kkikione999/zmgjb/code/C3/readme.md

2025_1020_14:58

使用slot去解决：用一个消息队列传输不同类型的消息
问题：传输不同的消息之后还得做不同字符类型消息的解包工作，不好，故弃用
