kkikione999/zmgjb/code/record/attitude_static_charts.png

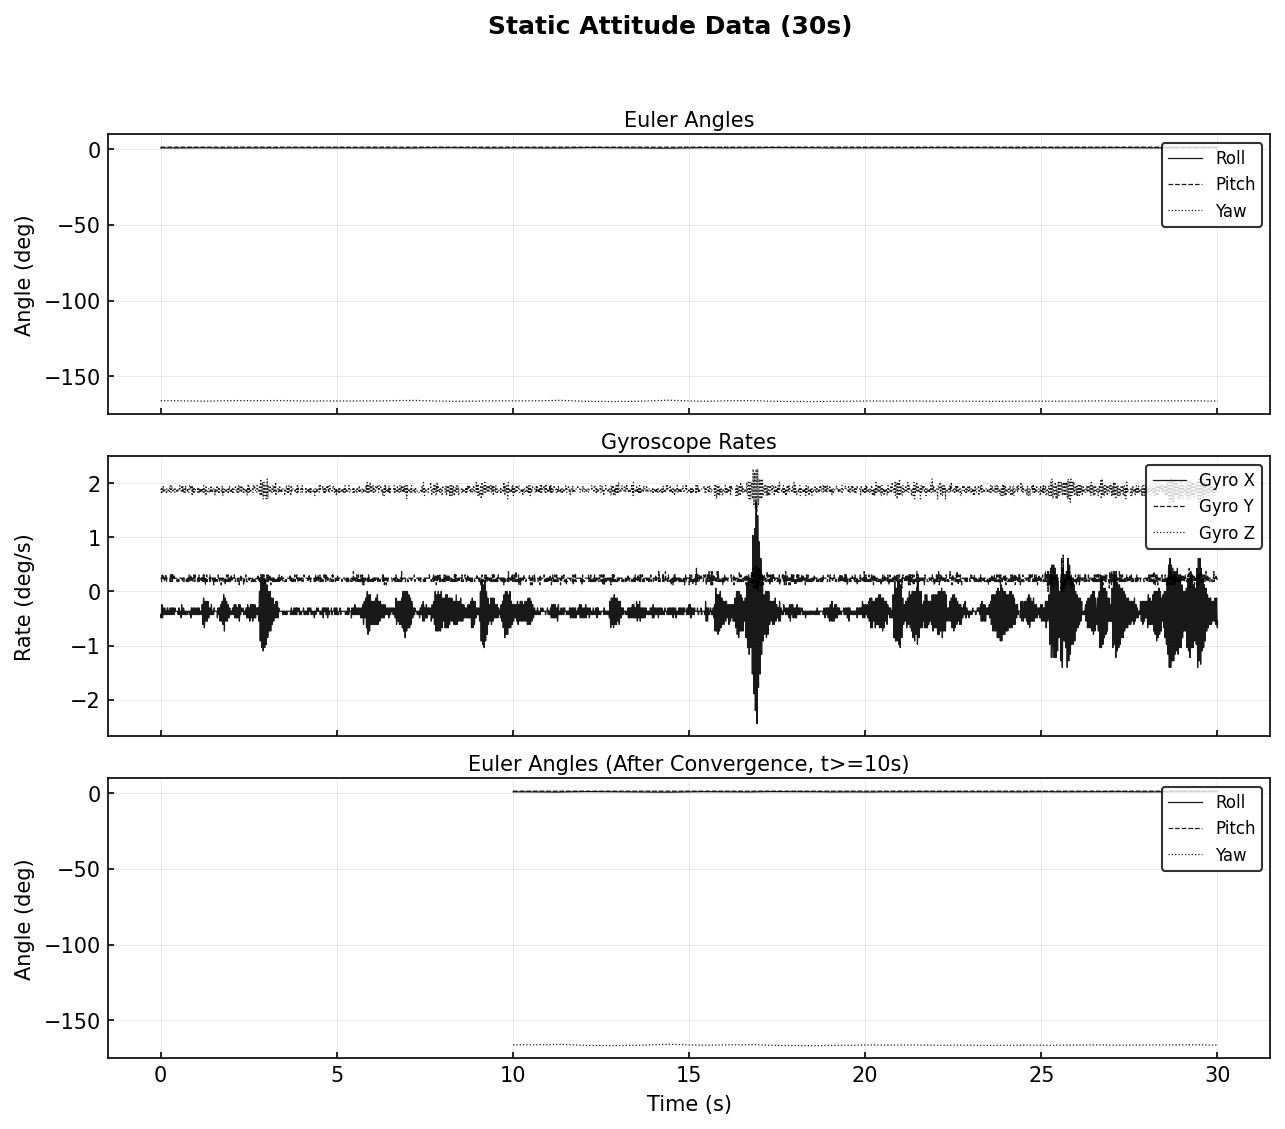
code/record/attitude_static_charts.png
