kkikione999/zmgjb/code/record/attitude_steady_detail.png

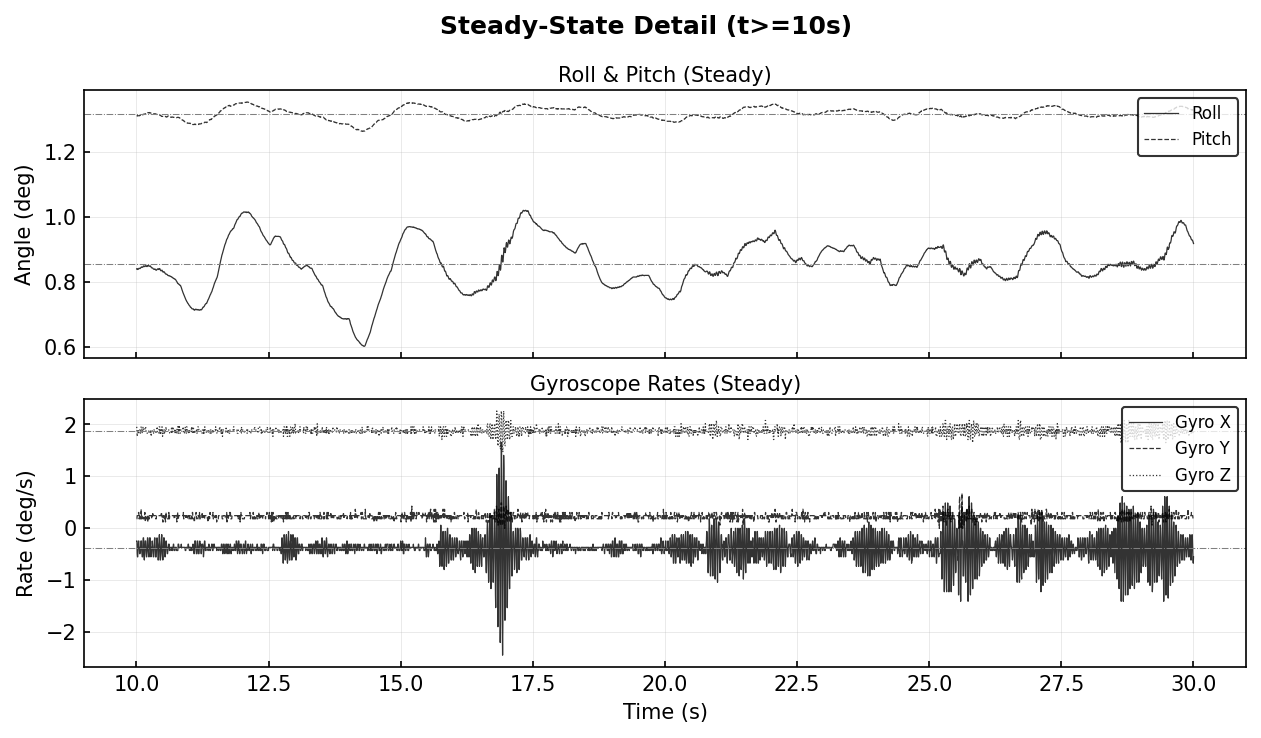
code/record/attitude_steady_detail.png
