kkikione999/zmgjb/code/record/rtt_comparison.png

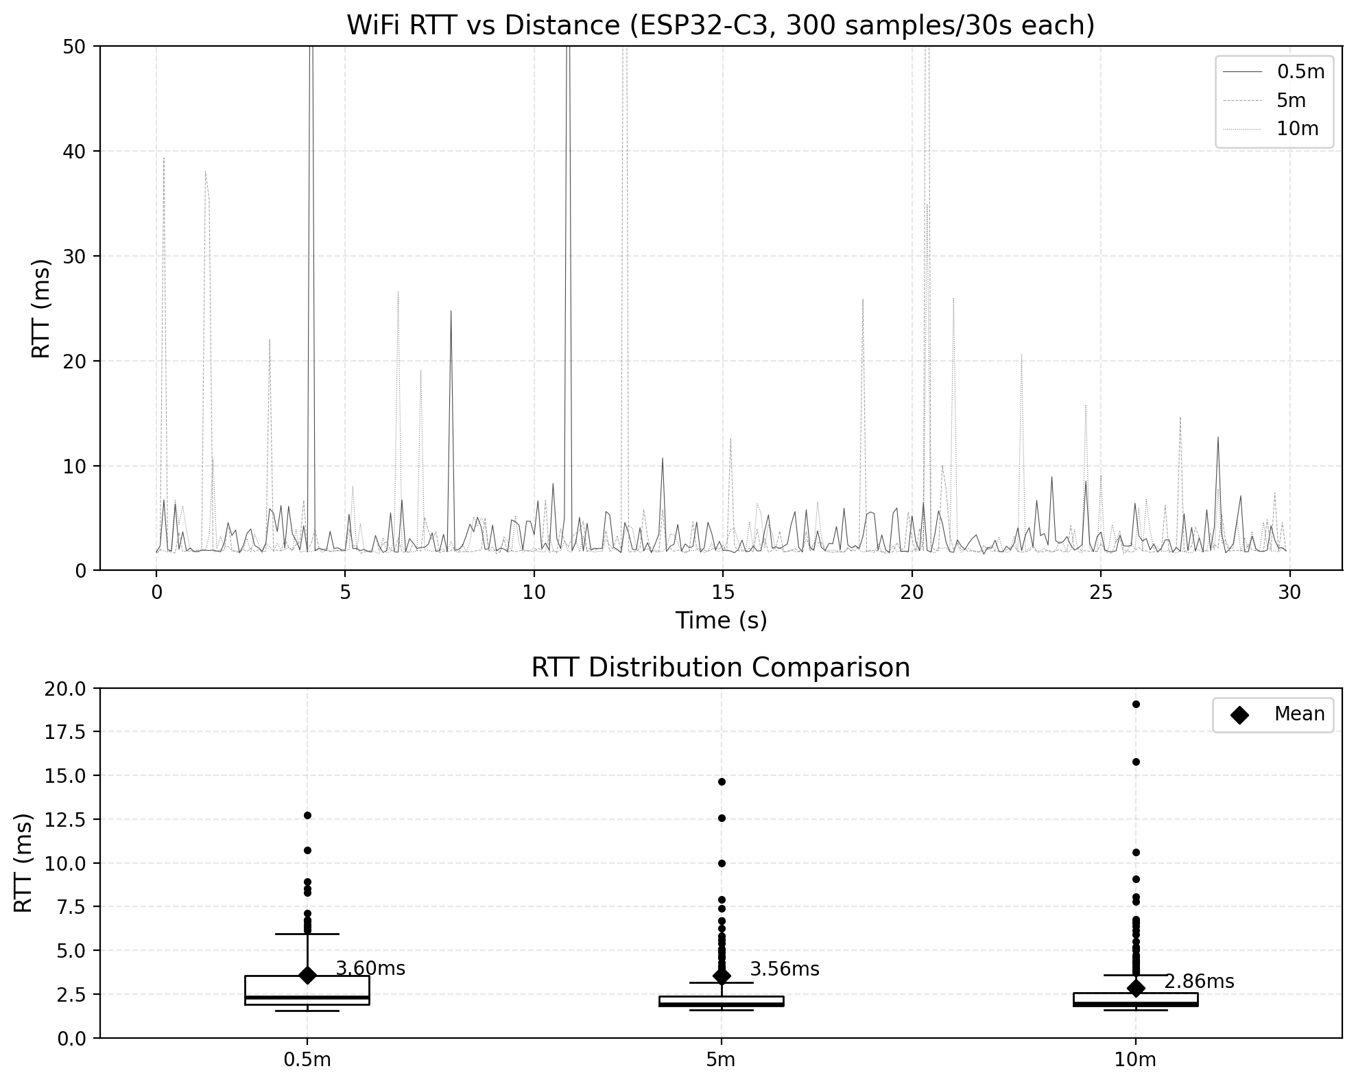
code/record/rtt_comparison.png
