kkikione999/zmgjb/hardware/原理图/主控/SCH_主控_1-P1_2026-03-11.pdf

IO19 27 IO18 26 NC 25 NC 24 IO9 23 IO8 22 IO7 21 IO6 20 IO5 19 IO4 18 NC 17 IO10 16 NC 15 GND 14 IO1 13 IO0 12 GND 11 NC 10 NC 9

# C1 10 GND 11 NC 12 NC 13 NC 14 NC 15 SDA 16

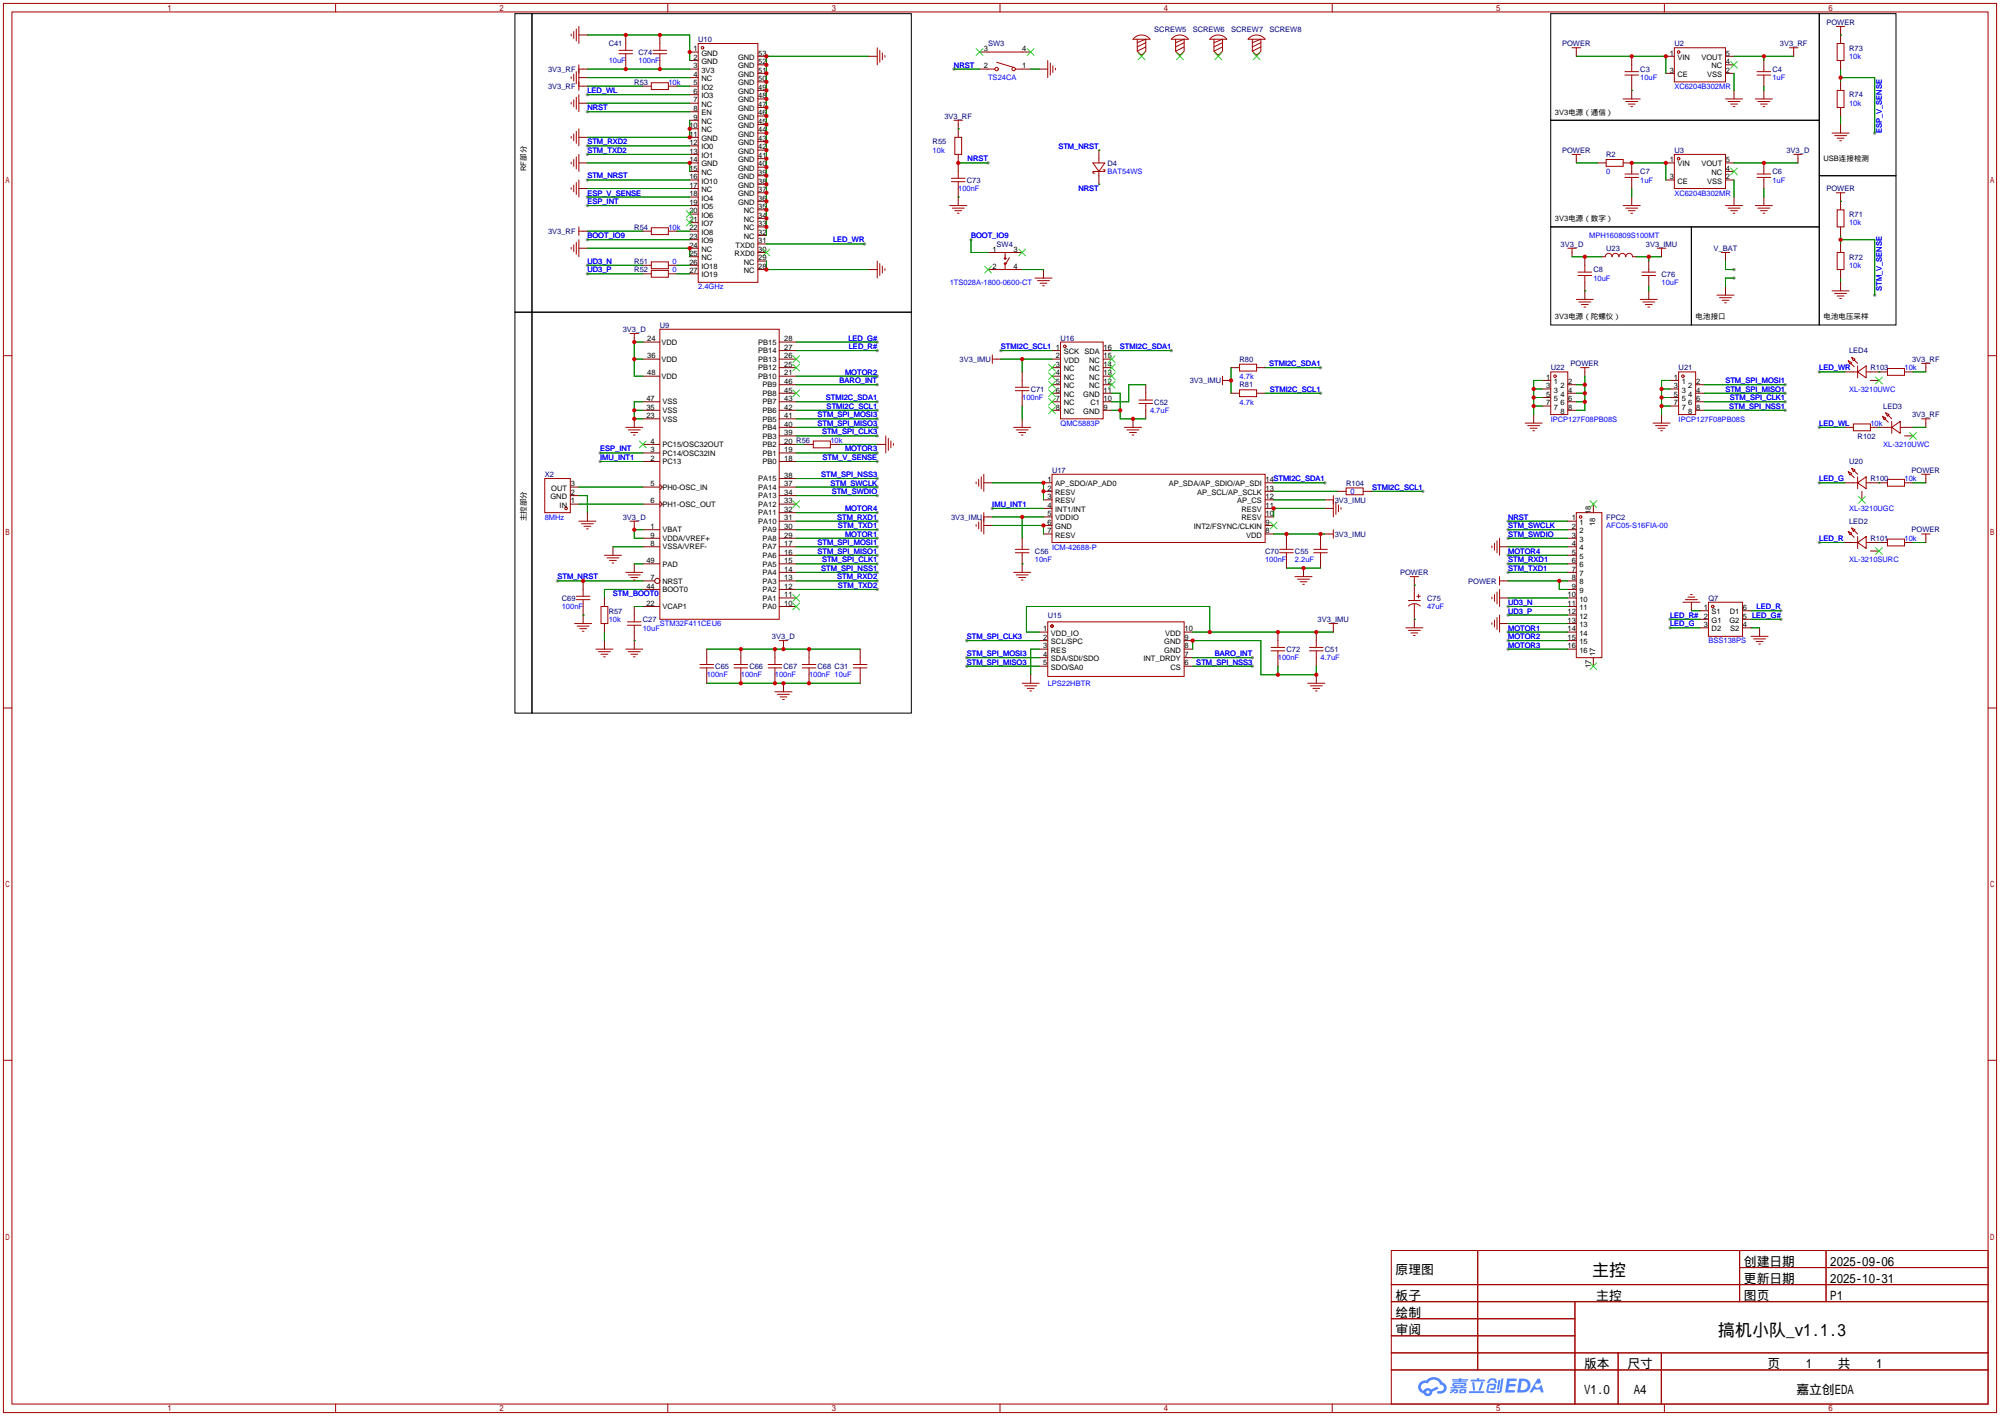
[picture p4: page 1]

原理图 | 主控 | 创建日期 | 2025-09-06

更新日期 | 2025-10-31

板子 | 主控 | 图页 | P1
绘制 | | 搞机小队_v1.1.3
审阅

V1.0 | A4 | 嘉立创EDA
