kkikione999/zmgjb/hardware/原理图/机身/SCH_机身_1-P1_2026-03-11.pdf

# FPC1 AFC⁰⁵⁻S¹⁶FIA⁻⁰⁰

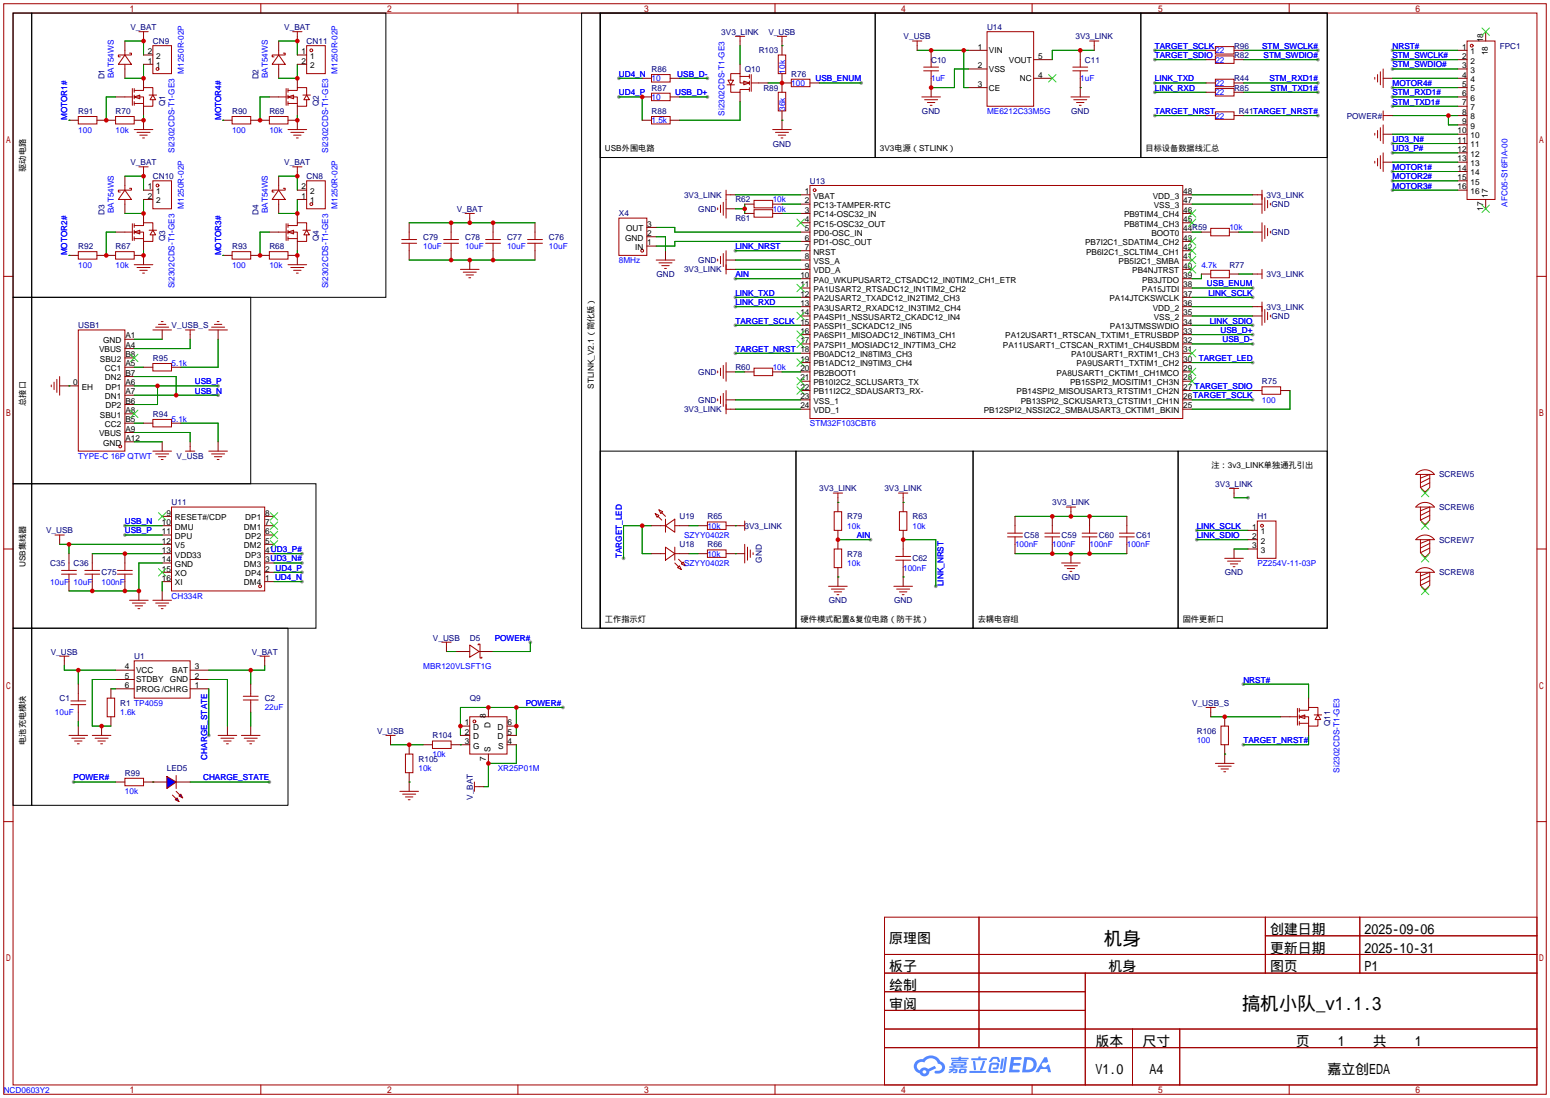
[picture p5: page 1]

原理图 | 机身 | 创建日期 | 2025-09-06

更新日期 | 2025-10-31

板子 | 机身 | 图页 | P1
绘制 | | 搞机小队_v1.1.3
审阅

V1.0 | A4 | 嘉立创EDA
