kkikione999/zmgjb/(list of files, drawings)

Other design files:
hardware/原理图/搞机小队_v1.1.3.eprj
