kkikione999/zmgjb/code/411/Core/Src/main.c

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
/* Includes ------------------------------------------------------------------*/
#include "main.h"
#include "cmsis_os.h"
#include "adc.h"
#include "dma.h"
#include "i2c.h"
#include "spi.h"
#include "tim.h"
#include "usart.h"
#include "gpio.h"

/* USER CODE BEGIN Includes */
#include "stdio.h"
#include "ICM42688.h"
#include "QMC5883P.h"
#include "LPS22HBTR.h"
#include "AHRS_Mahony.h"
#include "system_params.h"
/* USER CODE END Includes */

/* USER CODE BEGIN PTD */
//宏定义、常量、类型定义
extern UART_HandleTypeDef huart1;
extern lps22hb_t g_lps;
/* USER CODE END PTD */


void SystemClock_Config(void);
void MX_FREERTOS_Init(void);
/* USER CODE BEGIN PFP */
// 后期不需要测试可以删除
static inline HAL_StatusTypeDef ICM_SPI_Xfer(uint8_t *tx, uint8_t *rx, uint16_t len, uint32_t to_ms)
{

    return HAL_SPI_TransmitReceive(&hspi3, tx, rx, len, to_ms);
}
uint8_t SPI_Read_8BIT(uint8_t reg_address, uint8_t* read8bit)
{
    HAL_StatusTypeDef icm_err;
    uint8_t tx_buf[2] = { reg_address | 0x80, 0x00 };
    uint8_t rx_buf[2] = {0};
    HAL_GPIO_WritePin(Barometer_SPI_Software_NSS_GPIO_Port, Barometer_SPI_Software_NSS_Pin, GPIO_PIN_RESET);
    icm_err = ICM_SPI_Xfer(tx_buf, rx_buf, 2, 500);
    HAL_GPIO_WritePin(Barometer_SPI_Software_NSS_GPIO_Port, Barometer_SPI_Software_NSS_Pin, GPIO_PIN_SET);
    if (icm_err != HAL_OK) return 0;
    *read8bit = rx_buf[1];
    return 1;
}
/* USER CODE END PFP */

/**
  * @brief  The application entry point.
  * @retval int
  */
int main(void)
{

  /* USER CODE BEGIN 1 */
	/* git同步冲突测试点2 */

  /* USER CODE END 1 */
  /* MCU Configuration--------------------------------------------------------*/
  /* Reset of all peripherals, Initializes the Flash interface and the Systick. */
  HAL_Init();
  /* Configure the system clock */
  SystemClock_Config();

  /* Initialize all configured peripherals */
  MX_GPIO_Init();
  MX_DMA_Init();
  MX_ADC1_Init();
  MX_I2C1_Init();
  MX_SPI3_Init();
  MX_USART1_UART_Init();
  MX_USART2_UART_Init();
  MX_TIM1_Init();
  MX_TIM2_Init();
  MX_TIM3_Init();
  
  /* USER CODE BEGIN 2 */
  usart2_dma_rx_start();	           // 开启DMA 接收中断

  // 读取三个传感器 WHO_AM I 并通过串口输出
  {
    uint8_t id;
    HAL_StatusTypeDef status;

    printf("\r\n===== Sensor WHO_AM_I Check =====\r\n");

    // ICM42688-P (I2C1, addr 0x69)
    ICM_BANK_SWITCH(ICM42688_BANK_SEL_0);
    id = ICM42688_Read_WhoAmI();
    printf("ICM42688-P WHO_AM_I: 0x%02X (expect 0x47) %s\r\n",
           id, (id == 0x47) ? "[OK]" : "[FAIL]");

    // LPS22HBTR/LPS22HH (SPI3)
    status = LPS22HB_ReadWhoAmI(&g_lps, &id);
    if (status == HAL_OK) {
      printf("LPS22HB   WHO_AM_I: 0x%02X (expect 0xB1/0xB3) %s\r\n",
             id, (id == 0xB1 || id == 0xB3) ? "[OK]" : "[FAIL]");
    } else {
      printf("LPS22HB   WHO_AM_I: SPI read failed!\r\n");
    }

    // QMC5883P (I2C1, addr 0x2C)
    if (QMC_ReadChipID(&id) == QMC_OK) {
      printf("QMC5883P  CHIP_ID:  0x%02X (expect 0x80) %s\r\n",
             id, (id == 0x80) ? "[OK]" : "[FAIL]");
    } else {
      printf("QMC5883P  CHIP_ID:  I2C read failed!\r\n");
    }

    printf("==================================\r\n\r\n");
  }

  ICM42688_init();                     // 初始化陀螺仪
  QMC_Init();                          // 初始化磁力计
  Baro_Init();                         // 初始化气压计
  mahony_ahrs_init(2.0f, 0.01f);    // 初始化Mahony AHRS (Kp=2.0, Ki=0.01) - 优化参数
  mahony_set_params(2.0f, 0.01f, 2.0f);  // Kp=2.0, Ki=0.01, Kp_mag=2.0（强磁力计修正）
  /* USER CODE BEGIN 2 */
  {
    QMC5883P_Full_Calibration_t calib = {
      {34.50f, 445.00f, -12.00f},
      {
        {1.1112f, 0.0f, 0.0f},
        {0.0f, 1.0611f, 0.0f},
        {0.0f, 0.0f, 0.8638f}
      },
      1,
      1
    };
    QMC_Set_Full_Calibration(&calib);
  }
  /* USER CODE END 2 */
  motor_all_start();                   //初始化四个电机

#if defined(UART1_SMOKE_TEST) && (UART1_SMOKE_TEST == 1)
  {
    static const uint8_t uart1_smoke_msg[] = "UART1 smoke test 460800\r\n";
    while (1)
    {
      HAL_UART_Transmit(&huart1, (uint8_t *)uart1_smoke_msg, sizeof(uart1_smoke_msg) - 1U, 1000);
      HAL_Delay(500);
    }
  }
#endif

  /* USER CODE END 2 */
  /* Init scheduler */
  osKernelInitialize();  /* Call init function for freertos objects (in cmsis_os2.c) */
  MX_FREERTOS_Init();
  /* Start scheduler */
  osKernelStart();
  /* We should never get here as control is now taken by the scheduler */
  /* Infinite loop */
  /* USER CODE BEGIN WHILE */
  while (1)
  {
    /* USER CODE END WHILE */

    /* USER CODE BEGIN 3 */
  }
  /* USER CODE END 3 */
}

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
/* USER CODE BEGIN 4 */
void mag_pure_yaw_test(void)
{
    QMC5883P_Raw_Data_t raw_data, cal_data;
    float yaw_deg;
    float mag_strength_raw, mag_strength_cal;
    uint32_t last_print_time = 0;
    
    printf("\r\n");
    printf("===============================================\r\n");
    printf("        纯磁力计Yaw角测试\r\n");
    printf("===============================================\r\n\r\n");
    
    printf("测试说明：\r\n");
    printf("  - 只使用磁力计X/Y轴计算Yaw角\r\n");
    printf("  - 飞机保持水平，缓慢旋转360度\r\n");
    printf("  - 观察Yaw角是否平滑变化0~360度\r\n");
    printf("  - 按复位键退出测试\r\n\r\n");
    
    printf("开始测试...\r\n");
    printf("━━━━━━━━━━━━━━━━━━━━━━━━━━━━━━━━━━━━━━━━━━━━\r\n\r\n");
    
    HAL_Delay(1000);
    
    // 无限循环测试
    for(;;) {
        // 读取磁力计数据
        if(QMC_Read_Raw_DATA(&raw_data) == QMC_OK) {
            QMC_Read_Full_Calibrated_DATA(&cal_data);
            
            // 计算原始和校准后的磁场强度
            mag_strength_raw = sqrtf(raw_data.X * raw_data.X + 
                                     raw_data.Y * raw_data.Y + 
                                     raw_data.Z * raw_data.Z) * 0.000244140625f;
            
            mag_strength_cal = sqrtf(cal_data.X * cal_data.X + 
                                     cal_data.Y * cal_data.Y + 
                                     cal_data.Z * cal_data.Z) * 0.000244140625f;
            
            // 将磁力计数据转换到机体系（机体X←-MAG.Y，机体Y←MAG.X）
            float mag_x_body = (float)cal_data.X;
            float mag_y_body = -(float)cal_data.Y;

            // 使用机体系的X/Y计算Yaw角（水平面内的方位角）
            yaw_deg = atan2f(mag_y_body, mag_x_body) * 57.2957795f;  // rad to deg
            
            // 归一化到0~360度
            if(yaw_deg < 0.0f) {
                yaw_deg += 360.0f;
            }
            
            // 每200ms打印一次
            uint32_t current_time = HAL_GetTick();
            if((current_time - last_print_time) >= 200) {
                printf("原始: [%5d, %5d, %5d] %.3f G | ", 
                       raw_data.X, raw_data.Y, raw_data.Z, mag_strength_raw);
                printf("校准: [%5d, %5d, %5d] %.3f G | ", 
                       cal_data.X, cal_data.Y, cal_data.Z, mag_strength_cal);
                printf("Yaw: %6.1f°", yaw_deg);
                
                // 质量指示
                if(mag_strength_cal < 0.25f) {
                    printf(" [!] 磁场太弱");
                } else if(mag_strength_cal > 0.65f) {
                    printf(" [!] 磁场太强");
                } else {
                    printf(" [OK]");
                }
                
                printf("\r\n");
                last_print_time = current_time;
            }
        }
        
        HAL_Delay(10);
    }
}


/* USER CODE END 4 */

/**
  * @brief  Period elapsed callback in non blocking mode
  * @note   This function is called  when TIM10 interrupt took place, inside
  * HAL_TIM_IRQHandler(). It makes a direct call to HAL_IncTick() to increment
  * a global variable "uwTick" used as application time base.
  * @param  htim : TIM handle
  * @retval None
  */
void HAL_TIM_PeriodElapsedCallback(TIM_HandleTypeDef *htim)
{
  if (htim->Instance == TIM10)
  {
    HAL_IncTick();
  }
}

/**
  * @brief  This function is executed in case of error occurrence.
  * @retval None
  */
void Error_Handler(void)
{
  /* USER CODE BEGIN Error_Handler_Debug */
  /* User can add his own implementation to report the HAL error return state */
  __disable_irq();
  while (1)
  {
  }
  /* USER CODE END Error_Handler_Debug */
}
#ifdef USE_FULL_ASSERT
/**
  * @brief  Reports the name of the source file and the source line number
  *         where the assert_param error has occurred.
  * @param  file: pointer to the source file name
  * @param  line: assert_param error line source number
  * @retval None
  */
void assert_failed(uint8_t *file, uint32_t line)
{
  /* USER CODE BEGIN 6 */
  /* User can add his own implementation to report the file name and line number,
     ex: printf("Wrong parameters value: file %s on line %d\r\n", file, line) */
  /* USER CODE END 6 */
}
#endif /* USE_FULL_ASSERT */
