kkikione999/zmgjb/(commit log)

2026-04-04 Fix STM32 UART output
    [main.c, usart.c]
2026-04-04 Update STM32 sensor startup
2026-04-04 Update ESP32 bridge files
2026-05-13 Update project config and add CLAUDE.md
    - Update AGENTS.md with clarified rules
    - Fix ESP32 upload port to Mac USB path
    - Add CLAUDE.md project instructions
    - Add docs directory for documentation
    - Add .claude config
2026-05-13 Fix barometer driver to support both LPS22HB and LPS22HH variants
    LPS22HH returns WHO_AM_I=0xB3 instead of 0xB1, accept both IDs.
    [LPS22HBTR.c, LPS22HBTR.h]
2026-05-13 Fix ICM42688 IMU resolution initialization
    accel_curr_resolution and gyro_curr_resolution were never set because
    the calibration function was intentionally disabled. Add explicit
    resolution assignments at end of ICM42688_init() for ±8G/±2000dps.
    [ICM42688.c]
2026-05-13 Fix Mahony AHRS: sample period API and pitch direction
    - Add mahony_set_sample_period() to fix 10x integration error
    (config was 500Hz but posture_task runs at 50Hz)
    - Negate pitch in quaternion_to_euler() to match aviation convention
    (nose-up = positive pitch)
2026-05-13 Enable printf float support for serial debug output
    newlib-nano defaults to no %f formatting; add -Wl,-u,_printf_float.
2026-05-13 Integrate AHRS into posture_task and tune sensor filters
    posture_task: set 50Hz sample period, enable ATT roll,pitch,yaw output.
    sensor_task: increase filter alpha (gyro 0.4→0.8, accel 0.15→0.5,
    mag 0.08→0.3) for faster response, suppress noisy printf.
2026-05-13 Add sensor diagnostics, magnetometer calibration and barometer init
    - Print WHO_AM_I for all 3 sensors at startup
    - Initialize barometer (Baro_Init)
    - Set Mahony params: Kp_mag=2.0 for yaw stability
    - Load hardcoded magnetometer calibration (hard iron + soft iron)
    [main.c]
2026-05-13 Add serial flash script and Web Serial attitude viewer
    - flash_monitor.sh: compile, flash, reset, capture serial in one step
    - attitude_viewer.html: browser-based 3D drone visualization via
    Web Serial API, parses ATT:roll,pitch,yaw format
2026-05-13 Update CLAUDE.md with corrected sensor bus info and serial monitor docs
2026-05-13 Add motor test commands and cascaded PID control loop
    Stage 1 - Motor calibration:
    - USART1 interrupt RX + text command parser (m1-m4, all, stop, mix, sweep)
    - Python motor_test.py interactive tool (pyserial, auto-detect port)
    - Motor test mode bypass flag (g_motor_test_active) in maneuver_task
    Stage 2 - PID control loop:
    - PID_Calculate() with anti-windup, derivative LPF, output clamping
    - PID_Cascaded() for angle outer + rate inner loop
    - Global attitude_data_t shared between posture_task and maneuver_task
    - maneuver_task: open-loop → cascaded PID (Roll/Pitch dual, Yaw rate-only)
    - PWM_MAX raised from 80 to 999 (full ARR range)
    - SystemParams_Init() + PID_LoadFromParams() called at star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
2026-05-21 完成部分调试
    [attitude_static_1779171523.csv, rtt_0.5m.csv, rtt_10m.csv, rtt_5m.csv]
