kkikione999/zmgjb/(notices)

Notices in the files:
code/411/Core/Inc/dma.h:
Copyright (c) 2025 STMicroelectronics.
All rights reserved.
This software is licensed under terms that can be found in the LICENSE file
